Kody420/ModPad/Hardware/sliders_prototype.png

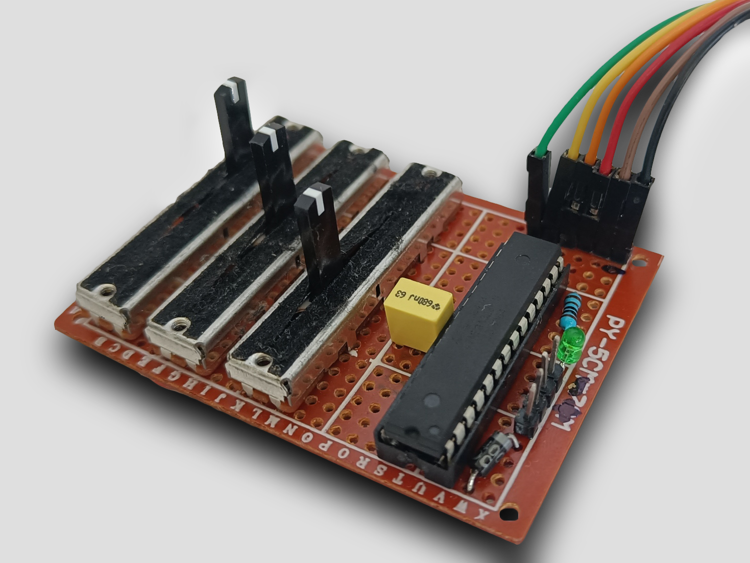
Hardware/sliders_prototype.png
