Kody420/ModPad/Hardware/ModPad 1.0 board.pdf

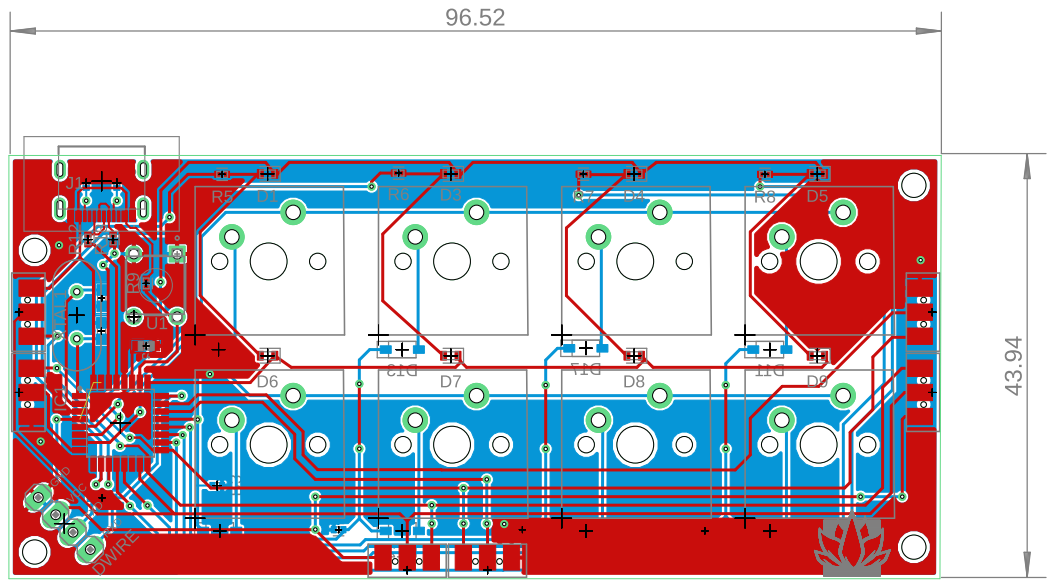
[picture p3: page 1]
