Kody420/ModPad/Hardware/ModPad 1.0 schematic.pdf

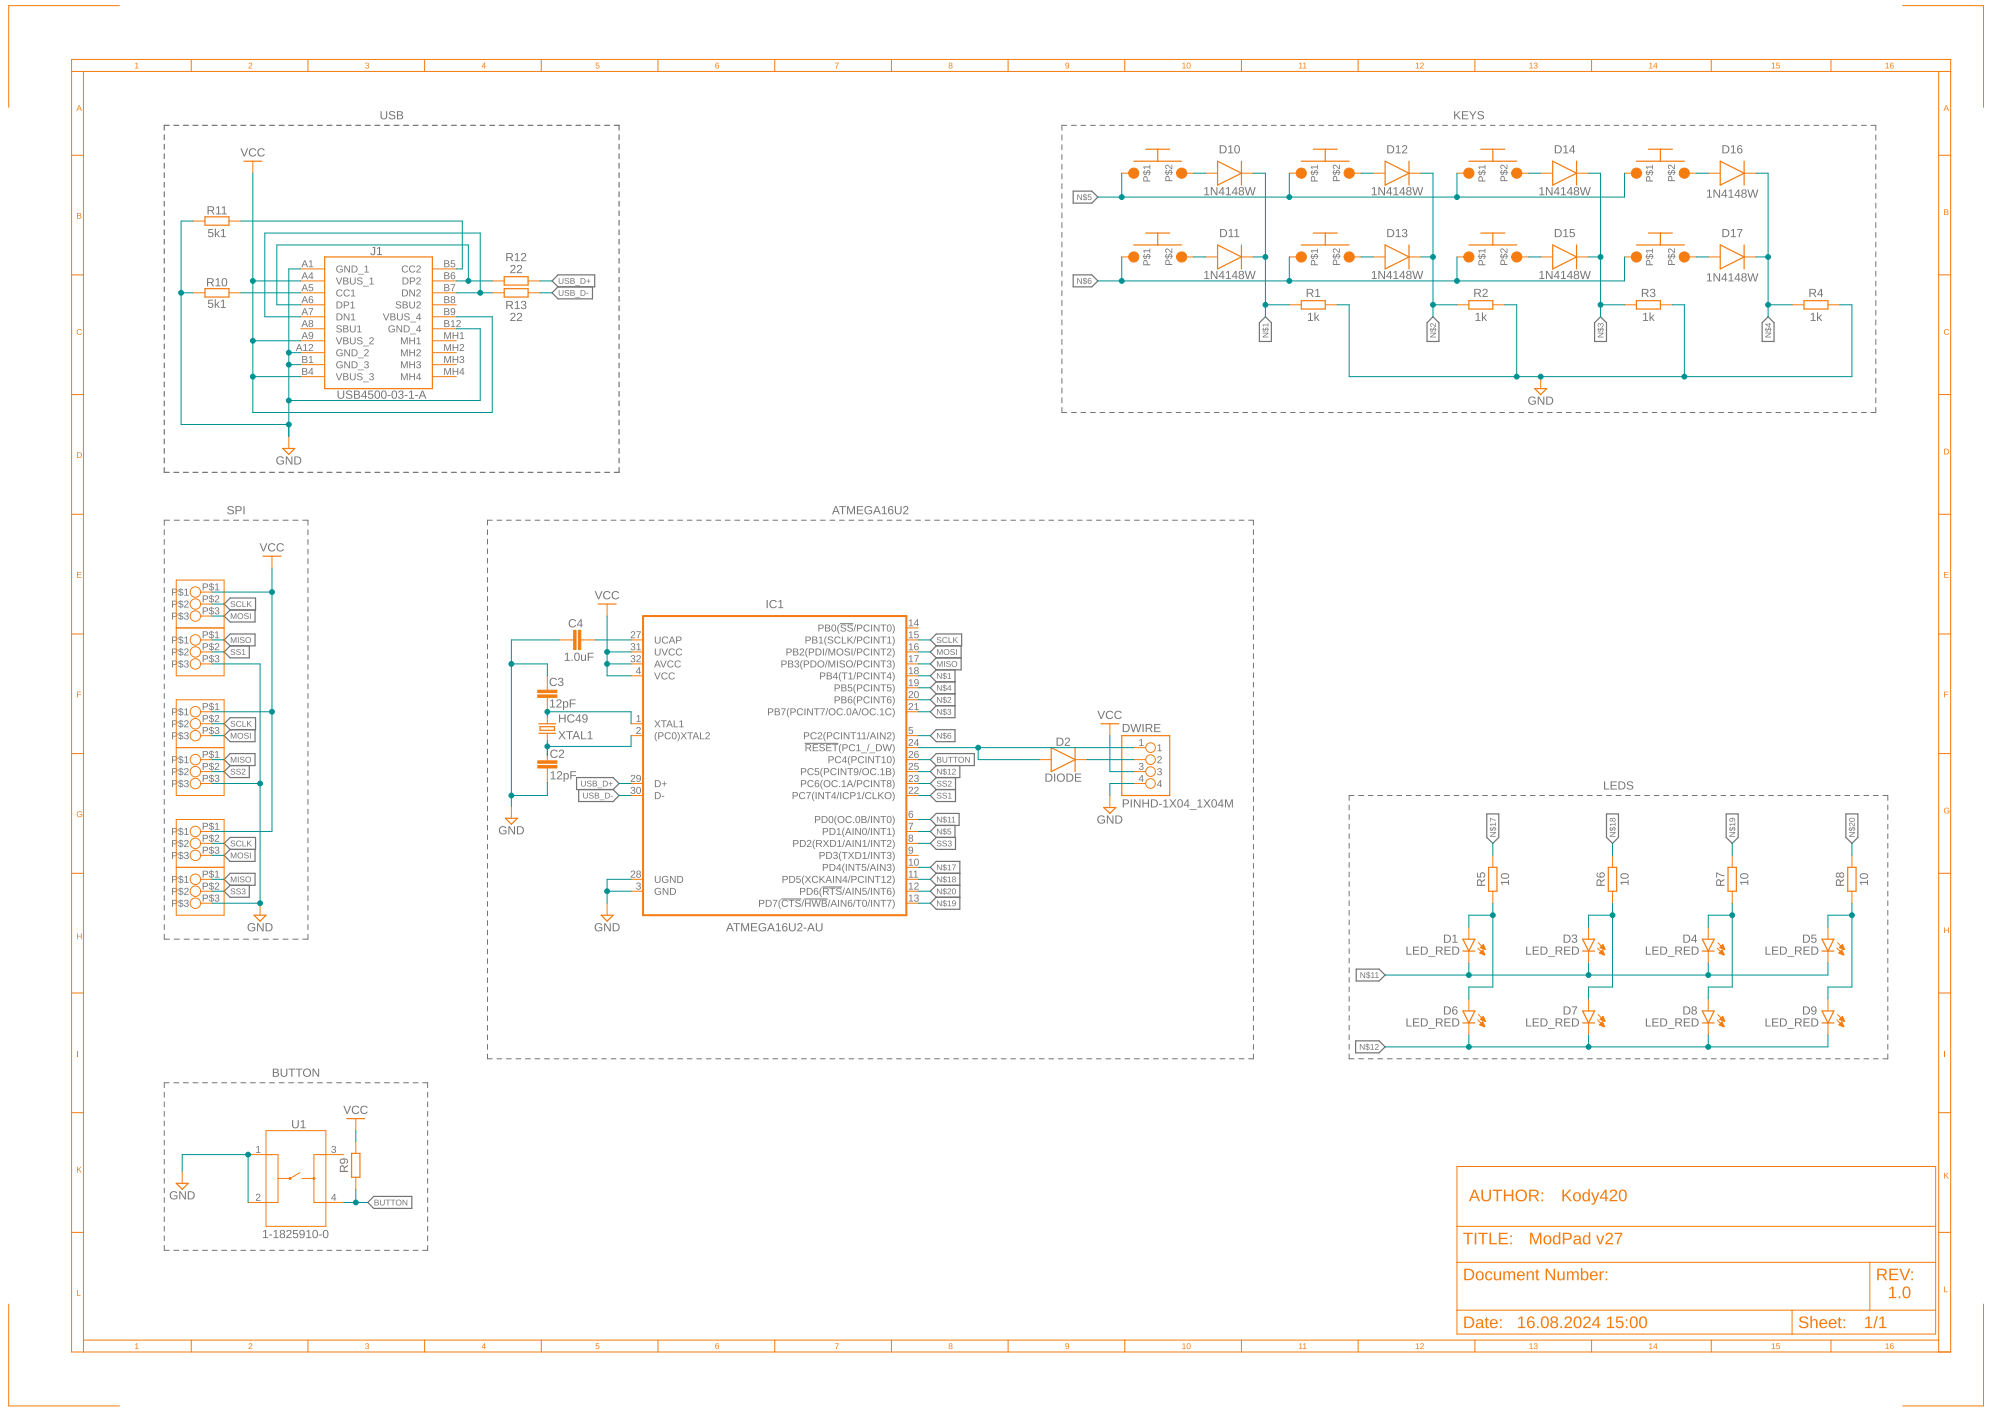
[picture p4: page 1]
