Kody420/ModPad/ModPad/Descriptors.h

/*
             LUFA Library
     Copyright (C) Dean Camera, 2021.

  dean [at] fourwalledcubicle [dot] com
           www.lufa-lib.org
*/

/*
  Copyright 2021  Dean Camera (dean [at] fourwalledcubicle [dot] com)

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
  The author disclaims all warranties with regard to this
  software, including all implied warranties of merchantability
  and fitness.  In no event shall the author be liable for any
  special, indirect or consequential damages or any damages
  whatsoever resulting from loss of use, data or profits, whether
  in an action of contract, negligence or other tortious action,
  arising out of or in connection with the use or performance of
  this software.
*/

/** \file
 *
 *  Header file for Descriptors.c.
 */

#ifndef _DESCRIPTORS_H_
#define _DESCRIPTORS_H_

	/* Includes: */
		#include <avr/pgmspace.h>

		#include <LUFA/Drivers/USB/USB.h>

	/* Type Defines: */
		/** Type define for the device configuration descriptor structure. This must be defined in the
		 *  application code, as the configuration descriptor contains several sub-descriptors which
		 *  vary between devices, and which describe the device's usage to the host.
		 */
		typedef struct
		{
			USB_Descriptor_Configuration_Header_t Config;

			// Combined Keyboard/Mouse HID Interface
			USB_Descriptor_Interface_t            HID_KeyboardInterface;
			USB_HID_Descriptor_HID_t              HID_KeyboardData;
			USB_Descriptor_Endpoint_t             HID_KeyboardINEndpoint;
			
			USB_Descriptor_Interface_t			  HID_SliderInterface;
			USB_HID_Descriptor_HID_t			  HID_SliderData;
			USB_Descriptor_Endpoint_t             HID_SliderINEndpoint;
		} USB_Descriptor_Configuration_t;

		/** Enum for the device interface descriptor IDs within the device. Each interface descriptor
		 *  should have a unique ID index associated with it, which can be used to refer to the
		 *  interface from other descriptors.
		 */
		enum InterfaceDescriptors_t
		{
			INTERFACE_ID_Keyboard = 0, /**< Combined keyboard and mouse interface descriptor ID */
			INTERFACE_ID_Slider = 1, /**< Combined keyboard and mouse interface descriptor ID */
		};

		/** Enum for the device string descriptor IDs within the device. Each string descriptor should
		 *  have a unique ID index associated with it, which can be used to refer to the string from
		 *  other descriptors.
		 */
		enum StringDescriptors_t
		{
			STRING_ID_Language     = 0, /**< Supported Languages string descriptor ID (must be zero) */
			STRING_ID_Manufacturer = 1, /**< Manufacturer string ID */
			STRING_ID_Product      = 2, /**< Product string ID */
		};

	/* Macros: */
		/** Endpoint address of the HID reporting IN endpoint. */
		#define KEYBOARD_IN_EPADDR             (ENDPOINT_DIR_IN | 1)
		
		#define SLIDER_IN_EPADDR             (ENDPOINT_DIR_IN | 2)

		/** Size in bytes of each of the HID reporting IN endpoint. */
		#define HID_EPSIZE                8

	/* Enums: */
		/** Enum for the HID report IDs used in the device. */
		enum HID_ReportID_t
		{
			HID_REPORTID_KeyboardReport = 0x01, /**< Report ID for the Keyboard report within the device. */
			HID_REPORTID_ConsumerReport = 0x02, /**< Report ID for the Mouse report within the device. */
			HID_REPORTID_FeatureReport = 0x03,
		};

	/* Function Prototypes: */
		uint16_t CALLBACK_USB_GetDescriptor(const uint16_t wValue,
		                                    const uint16_t wIndex,
		                                    const void** const DescriptorAddress)
		                                    ATTR_WARN_UNUSED_RESULT ATTR_NON_NULL_PTR_ARG(3);

#endif
