Kody420/ModPad/ModPad/prototype_modules/Sliders/Charlieplexing.h

/*
 * Charlieplexing.h
 *
 * Created: 06.09.2024 16:36:24
 *  Author: Kody
 */ 


#ifndef CHARLIEPLEXING_H_
#define CHARLIEPLEXING_H_
	
	#define F_CPU 16000000
	//Includes:
		#include <avr/io.h>
		#include <avr/interrupt.h>
		#include <stdbool.h>
		#include <util/delay.h>
		#include <limits.h>
		#include <avr/eeprom.h>
		#include "Delay.h"
		#include "../../Includes/usb_hid_keys.h"
	
	//Macros:
		#define LEDA1 PD6
		#define LEDB2 PD5
		#define LED3 PD4
		#define LEDS (LEDA1 | LEDB2 | LED3)
		#define NUM_OF_LEDS 6
		#define LED_COLUMN_SIZE 3
		#define LED_ROW_SIZE 2
		
	//EEPROM variables:
		extern uint16_t EEMEM eepromEffectNum;
	//Variables:
		
	//Functions:
		uint16_t CharliPlexInit(void);
		void CharliPlexEffect(uint16_t effectNum, uint8_t* sliderValues);
		void CharliPLexModifier(uint16_t modifierEffect);
		
#endif /* CHARLIEPLEXING_H_ */
