Kody420/ModPad/(commit log)

2024-08-16 added board and schematic
2024-08-20 Fixed most effects and feature report handeling
    [LedMatrix.c, ModPad.c]
2024-09-05 Add SPI communication and USB interface for slider module
2024-09-06 Add prototype of slider module
2024-09-09 Add charlieplexing led driver for module Sliders
2024-09-12 Faster and better handeling of SPI communication
2024-09-13 Resolved LEDs not turning off (fix #2)
    [LedMatrix.c]
2024-09-20 Clearer addressing of LEDs in Charlieplexing
2024-09-23 Separating LedMatrixEffect in to more functions, saving maxBrightness
